ChrGri/Diy_Hardware_BrakeResistor/CAD/BrakeResistor_8040_Enclosure.png

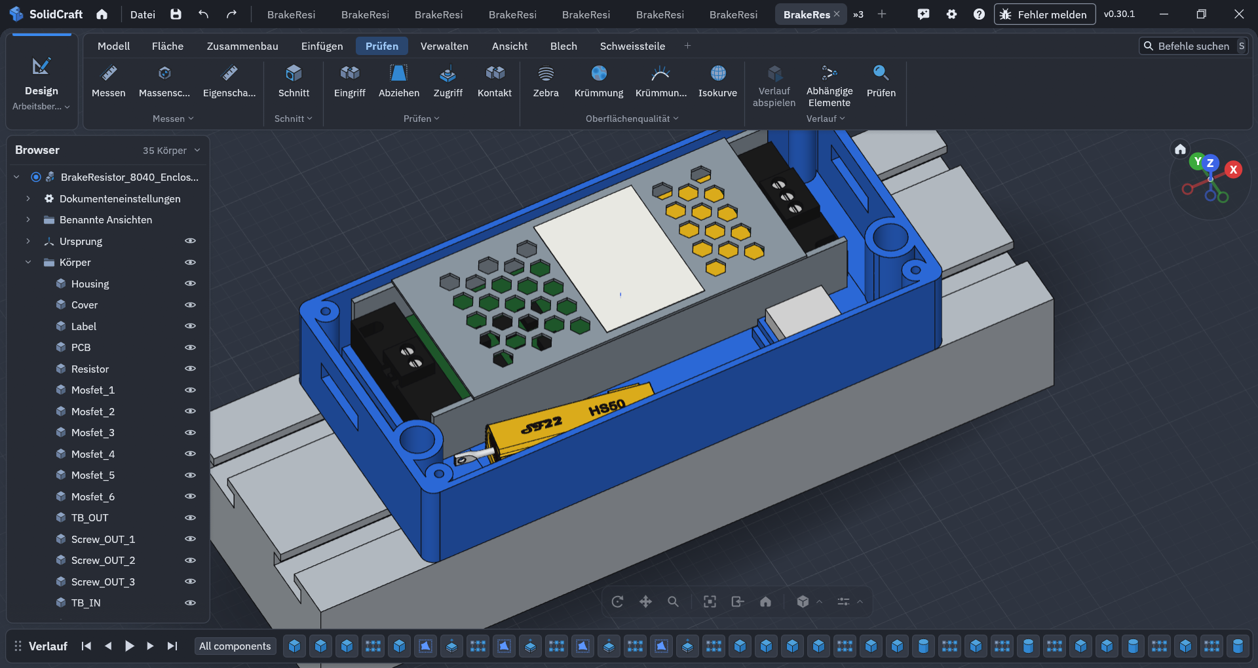
CAD/BrakeResistor_8040_Enclosure.png
