ChrGri/Diy_Hardware_BrakeResistor/CAD/MKS_BrakeResistor_V1_mockup.png

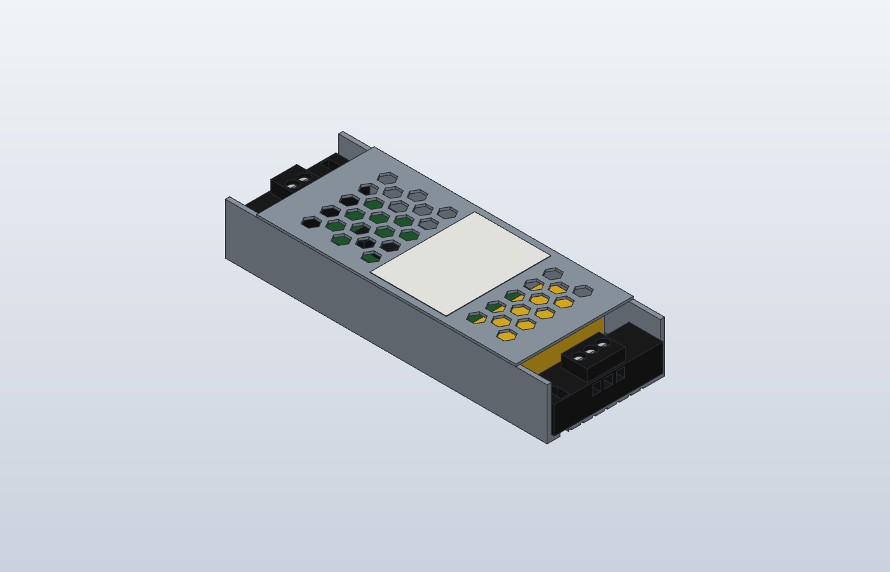
CAD/MKS_BrakeResistor_V1_mockup.png
