ChrGri/Diy_Hardware_BrakeResistor/CAD/renders/closed_top.png

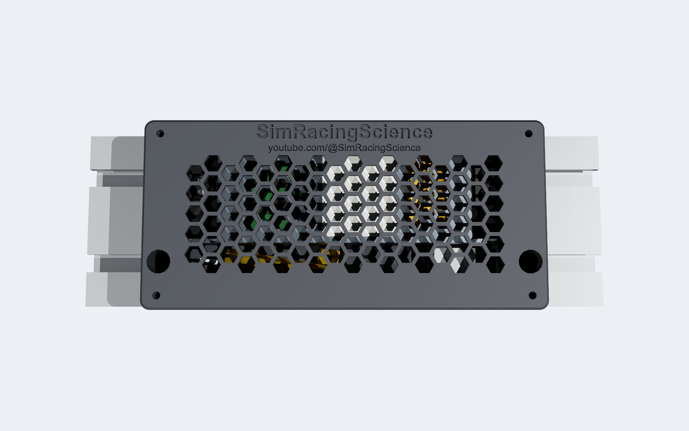
CAD/renders/closed_top.png
