ChrGri/Diy_Hardware_BrakeResistor/CAD/renders/open_iso.png

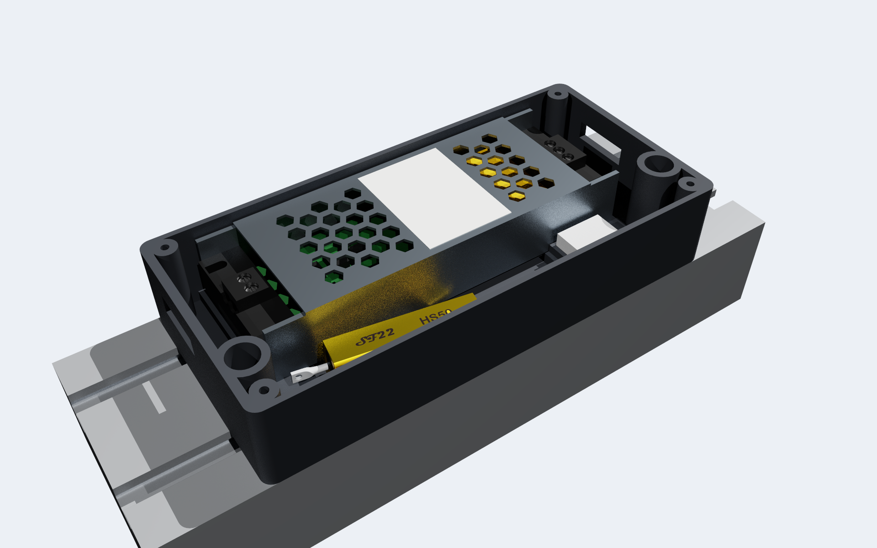
CAD/renders/open_iso.png
