ChrGri/Diy_Hardware_BrakeResistor/3d_print/MKS_BrakeResistor_8040_Lid.3mf

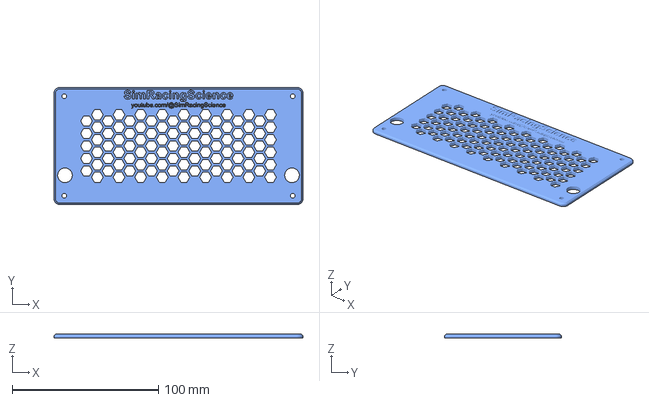
[picture p8: CAD file, 2026-11-04]
3d_print/MKS_BrakeResistor_8040_Lid.3mf
170.0 x 80.0 x 2.50 mm
