ChrGri/Diy_Hardware_BrakeResistor/CAD/HS50_power_resistor.stp

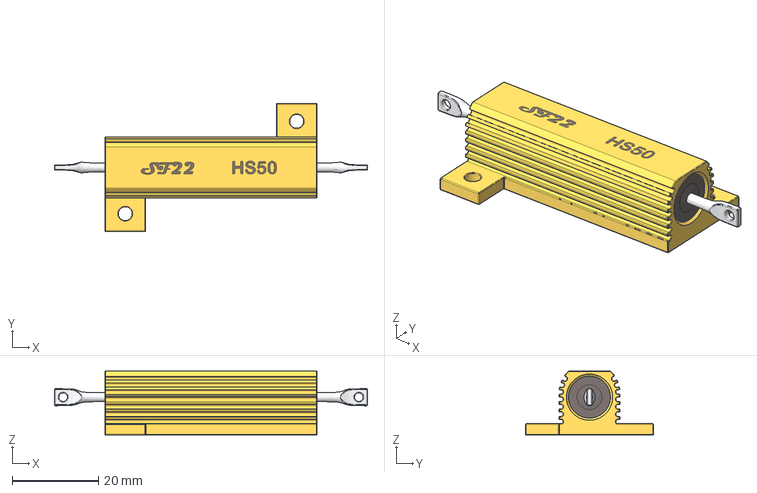
[picture p9: CAD file, 2026-11-04]
CAD/HS50_power_resistor.stp
72.5 x 29.7 x 14.8 mm
