ChrGri/Diy_Hardware_BrakeResistor/3d_print/MKS_BrakeResistor_8040_Tray.3mf

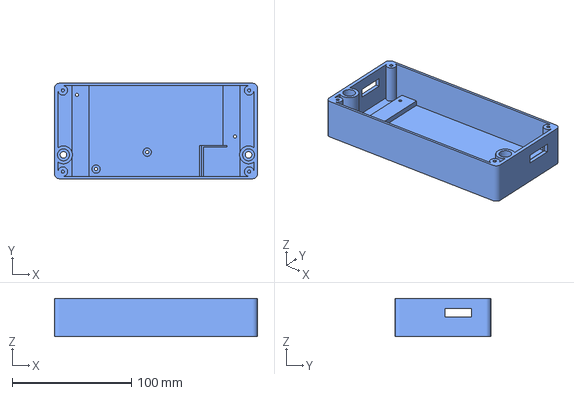
[picture p10: CAD file, 2026-11-04]
3d_print/MKS_BrakeResistor_8040_Tray.3mf
170.0 x 80.0 x 32.0 mm
