ChrGri/Diy_Hardware_BrakeResistor/CAD/MKS_BrakeResistor_V1_mockup.step

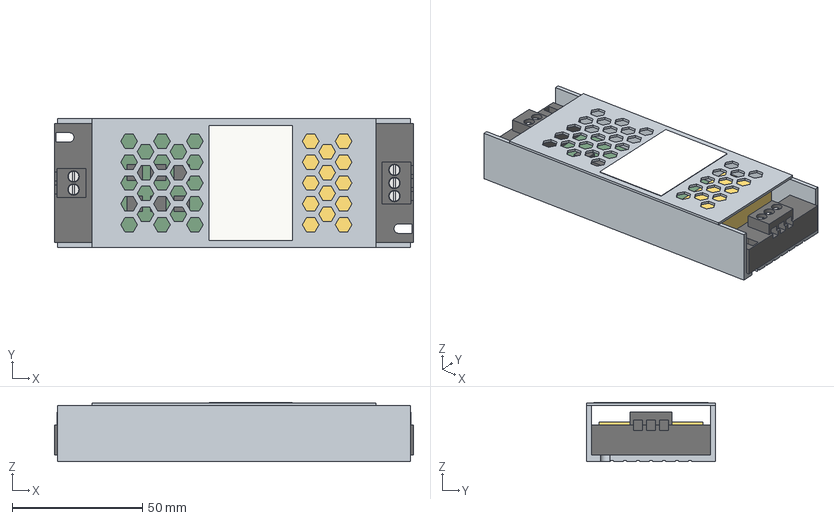
[picture p11: CAD file, 2026-11-04]
CAD/MKS_BrakeResistor_V1_mockup.step
137.6 x 49.4 x 22.7 mm
