ChrGri/Diy_Hardware_BrakeResistor/3d_print/HardwareBrakeResistorHousing_V1.3mf

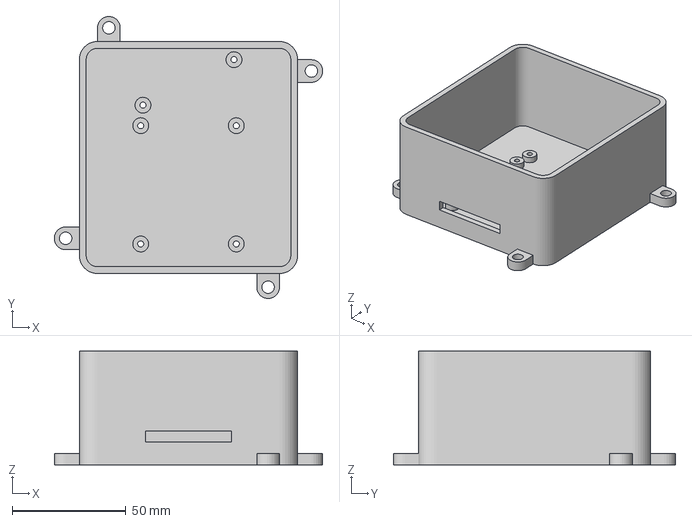
[picture p12: CAD file, 2026-10-07]
3d_print/HardwareBrakeResistorHousing_V1.3mf
117.9 x 123.9 x 50.0 mm
