ChrGri/Diy_Hardware_BrakeResistor/CAD/BrakeResistor_8040_Enclosure.step

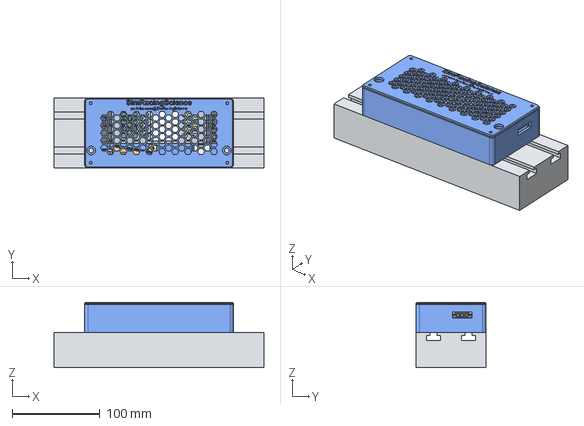
[picture p13: CAD file, 2026-11-04]
CAD/BrakeResistor_8040_Enclosure.step
240.0 x 80.0 x 74.5 mm
