ChrGri/Diy_Hardware_BrakeResistor/(commit log)

2026-10-07 Initial commit: DIY hardware brake resistor build guide
    [HardwareBrakeResistorHousing_V1.3mf]
2026-10-07 Add brake stroke scope measurement, compress images
2026-10-07 Add installation, soldered variant and housing photos; document direct PSU-module-servo wiring
2026-10-07 Adopt belt tensioner README style: banner, badges, donation and license sections
2026-10-17 Add wiring diagram for PSU, MOSFET board and servos
2026-10-17 Wiring diagram: zener on lower JST pin, jumper on upper pin
2026-11-04 Add MKS brake resistor module variant with 8040 enclosure
    - README now compares two variants: DIY MOSFET board and MKS module
    - Move the DIY build guide to docs/BuildGuide_DIY_MOSFET.md
    - Add MKS build guide with BOM, wiring diagram and rig photos
    - Add SolidCraft CAD for the 8040 enclosure, renders and print files
    - Add pedal log analysis (power, bus voltage, resistor sizing)
    [BrakeResistor_8040_Enclosure.step, Enclosure_Lid.3mf, Enclosure_Tray.3mf, HS50_power_resistor.stp, MKS_BrakeResistor_8040_Lid.3mf, MKS_BrakeResistor_8040_Tray.3mf, MKS_BrakeResistor_V1_mockup.step]
